josepala650/robot_sumo_Arduino_650/chasis_sumo_costado_izquierdo.STL

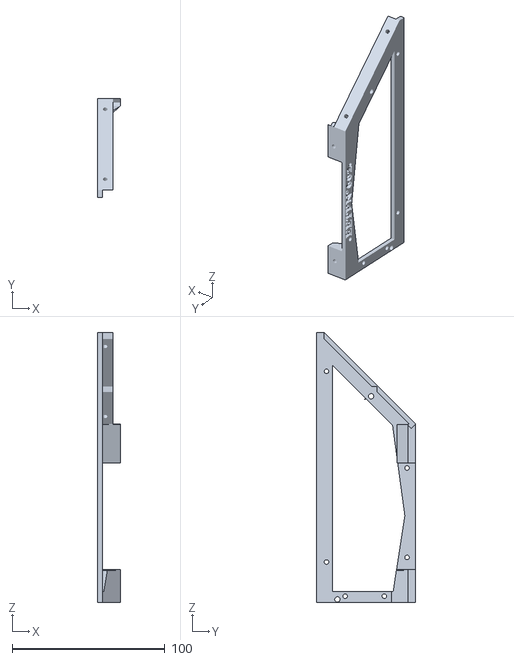
[picture p1: CAD file, 2022-10-15]
chasis_sumo_costado_izquierdo.STL
15.0 x 65.0 x 177.0
