josepala650/robot_sumo_Arduino_650/chasis sumo_soporte sensores_ultrasonicox1_2019.stl

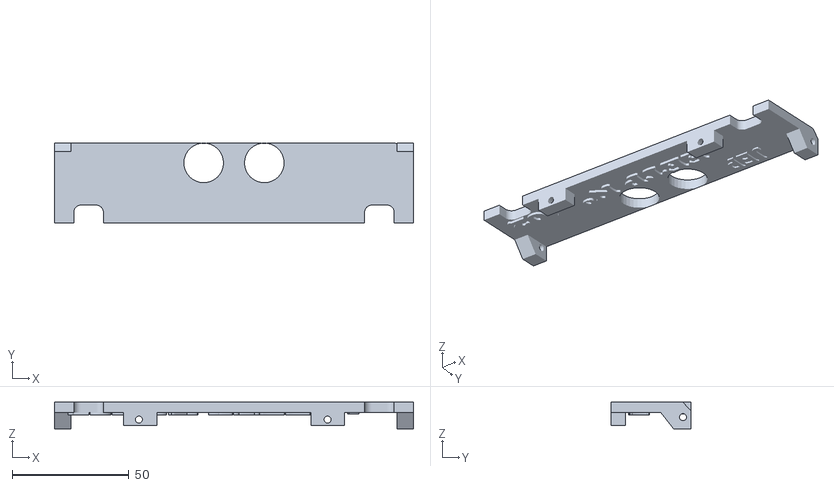
[picture p2: CAD file, 2022-10-15]
chasis sumo_soporte sensores_ultrasonicox1_2019.stl
154.0 x 34.3 x 11.4
