josepala650/robot_sumo_Arduino_650/chasis_sumo_trasero.STL

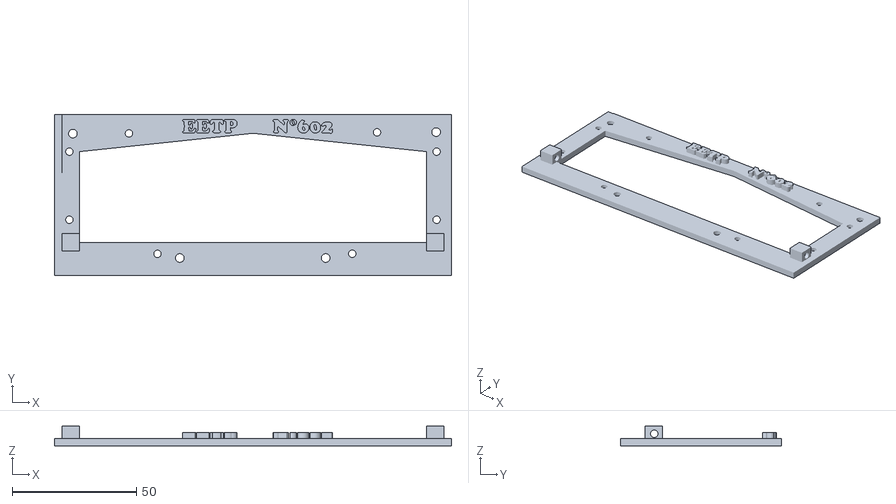
[picture p3: CAD file, 2022-10-15]
chasis_sumo_trasero.STL
160.0 x 65.0 x 8.00
