josepala650/robot_sumo_Arduino_650/chasis_sumo_tapa_motor_arduino.STL

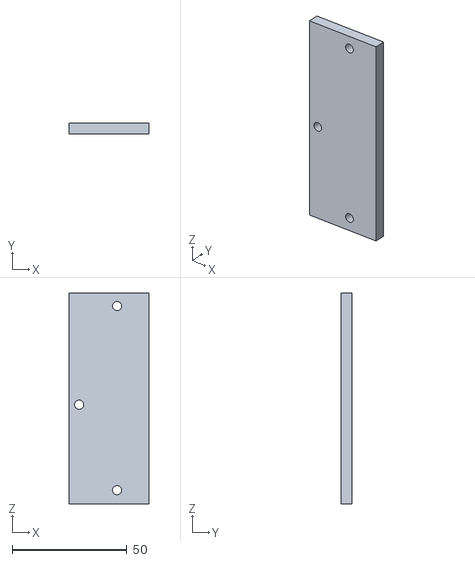
[picture p4: CAD file, 2022-10-15]
chasis_sumo_tapa_motor_arduino.STL
34.7 x 5.00 x 92.0
