josepala650/robot_sumo_Arduino_650/chasis_sumo_base5.STL

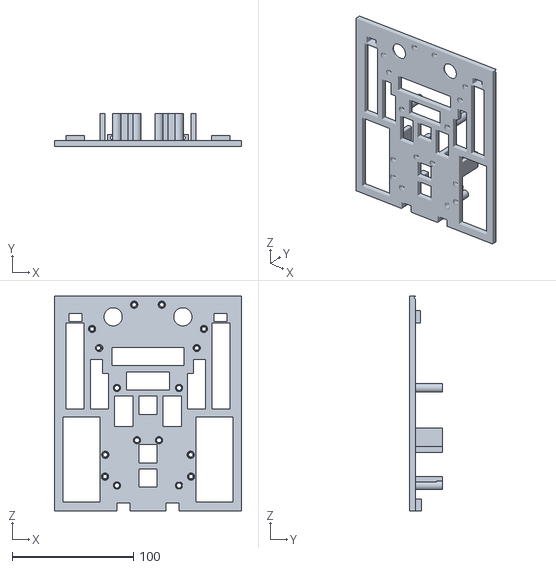
[picture p5: CAD file, 2022-10-15]
chasis_sumo_base5.STL
154.0 x 27.0 x 177.0
