josepala650/robot_sumo_Arduino_650/(list of files, cad)

Other CAD files:
chasis_sumo_costado_derecho.STL
chasis sumo_soporte sensores_ultrasonicox2_2019.stl
chasis_sumo_soporte_sensores.STL
